L9nhat/Captone-Project/ban_ve in 3d 2.pdf

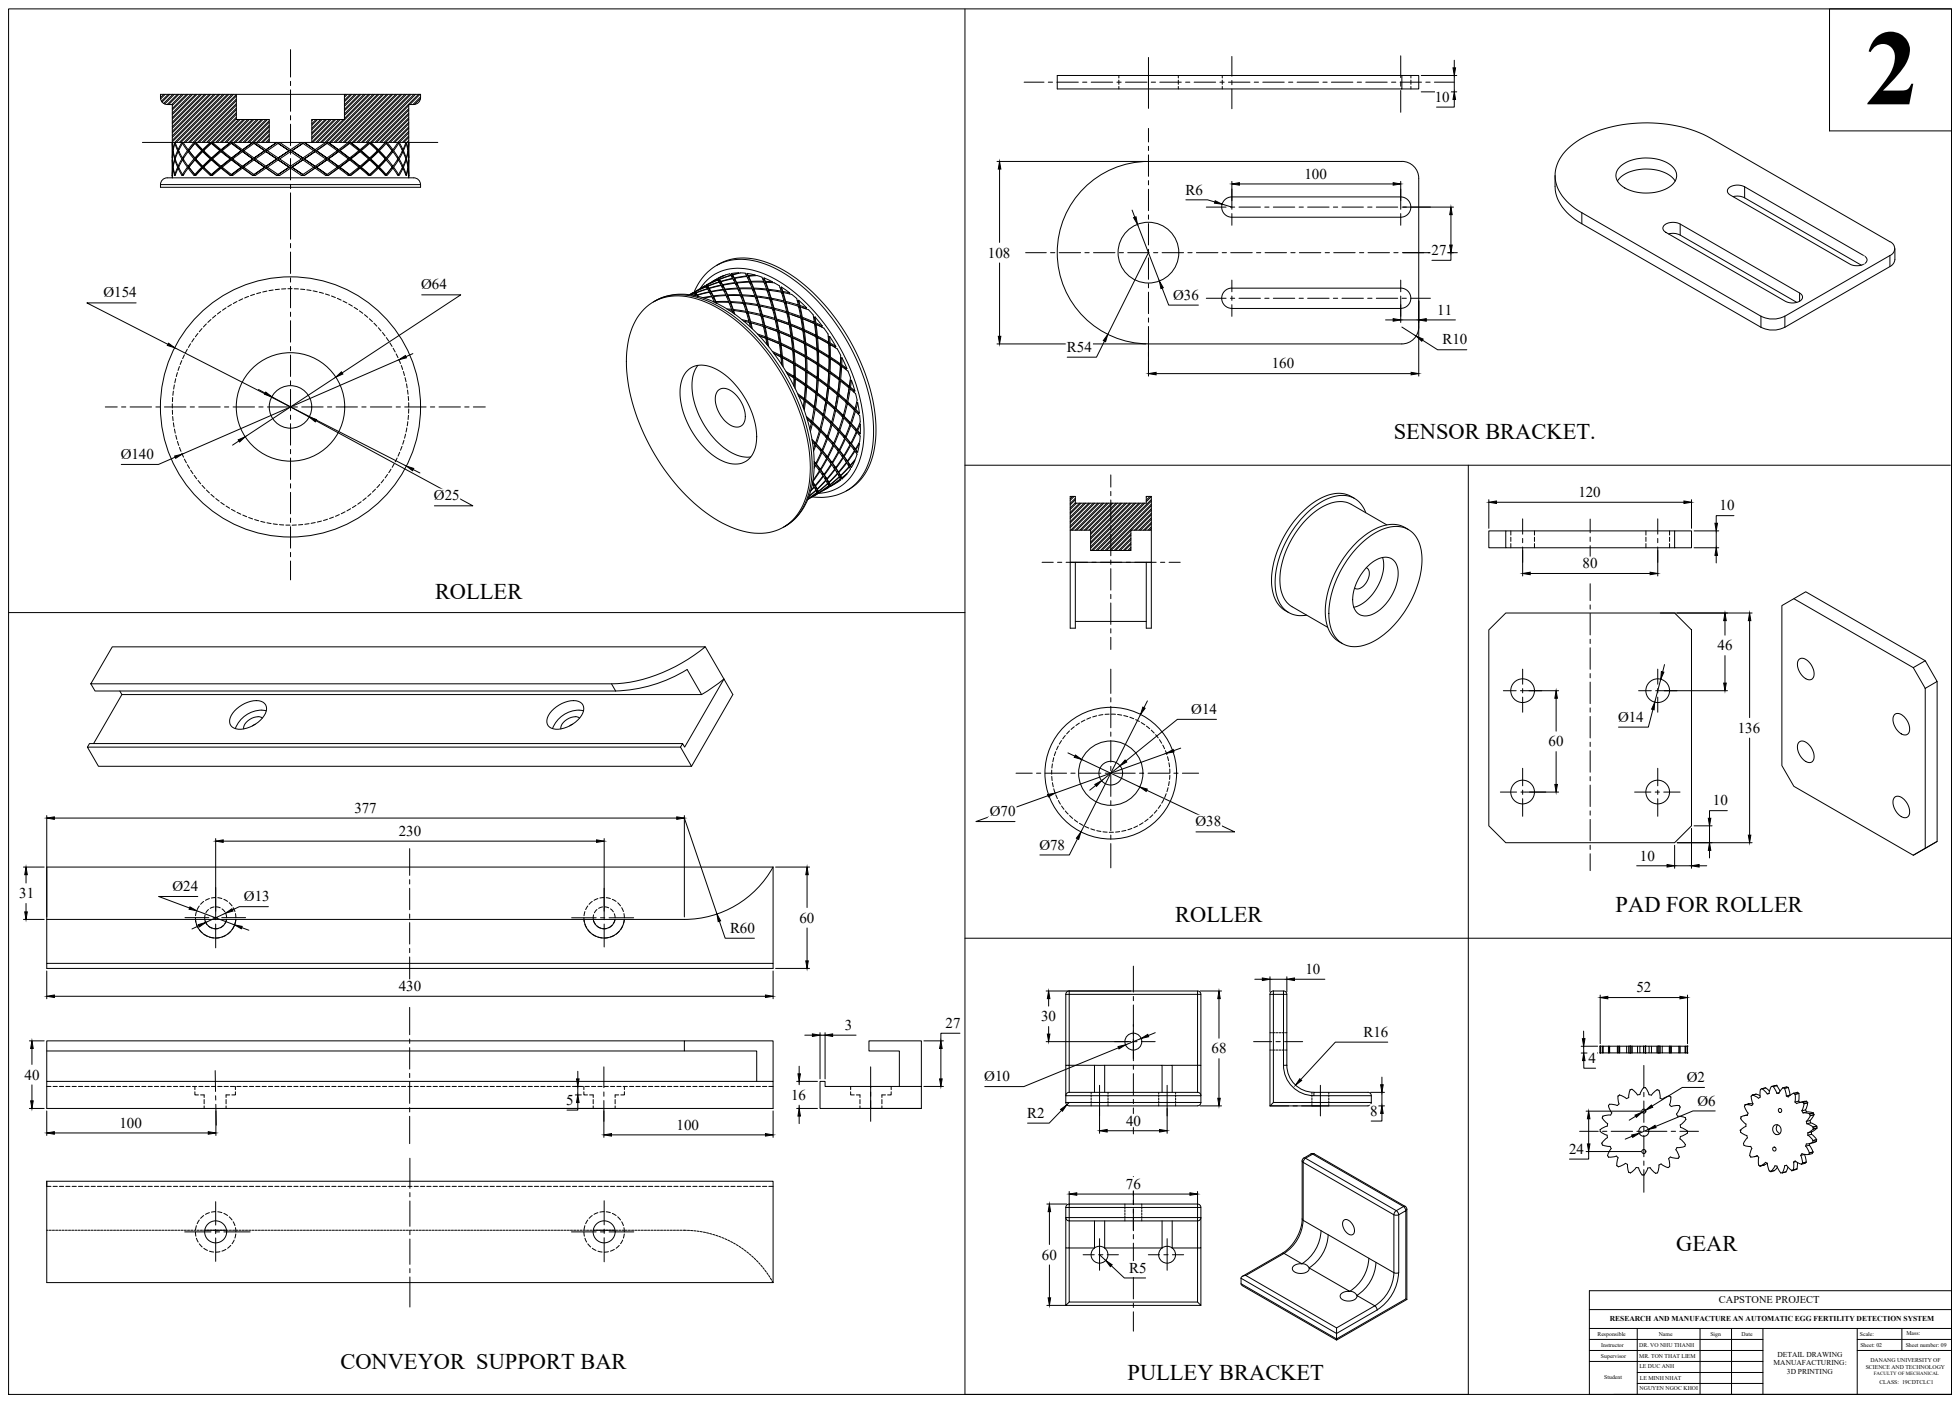
[picture p59: page 1]
ROLLER; SENSOR BRACKET. PAD FOR ROLLER CONVEYOR SUPPORT BAR; PULLEY BRACKET Ø14 Ø38 Ø78 Ø70 Ø64Ø25 Ø154Ø140; GEAR; 2 DETAIL DRAWING MANUAFACTURING: 3D PRINTING RESEARCH AND MANUFACTURE AN AUTOMATIC EGG FERTILITY DETECTION SYSTEM CAPSTONE PROJECT; Scale:; Sheet number: 09 Mass: Sheet: 02 DANANG UNIVERSITY OF SCIENCE AND TECHNOLOGY CLASS: 19CDTCLC1 Responsible Instructor Supervisor Student; Name; Sign; Date DR. VO NHU THANH LE MINH NHAT MR. TON THAT LIEM NGUYEN NGOC KHOI LE DUC ANH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
