L9nhat/Captone-Project/ban_ve in 3d.pdf

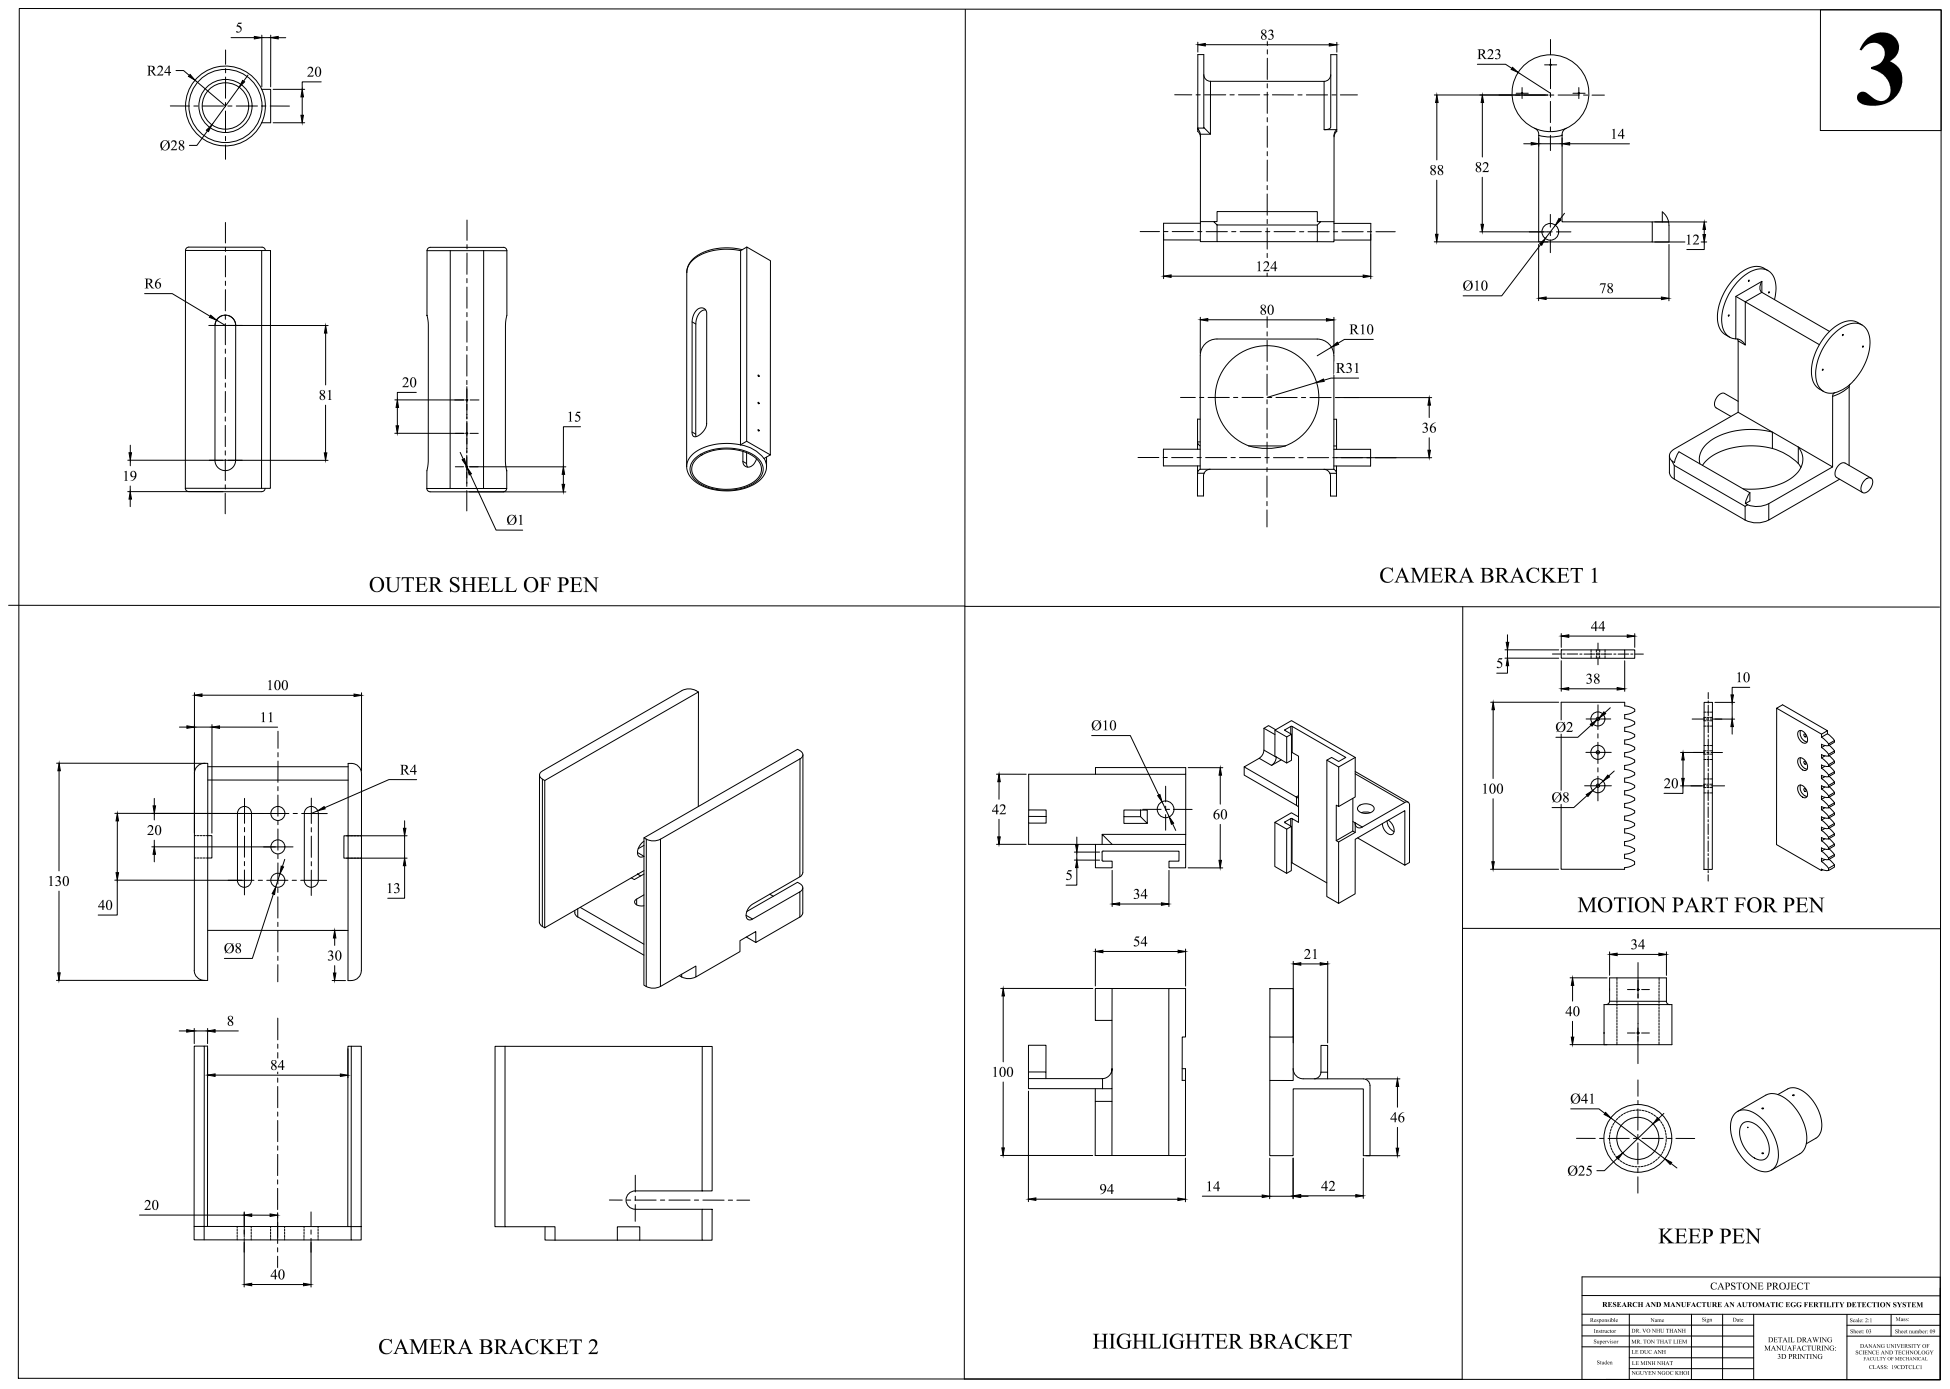
[picture p60: page 1]
OUTER SHELL OF PEN; CAMERA BRACKET 1 MOTION PART FOR PEN CAMERA BRACKET 2; HIGHLIGHTER BRACKET; KEEP PEN 130; 3 DETAIL DRAWING MANUAFACTURING: 3D PRINTING RESEARCH AND MANUFACTURE AN AUTOMATIC EGG FERTILITY DETECTION SYSTEM CAPSTONE PROJECT; Scale: 2:1; Sheet number: 09 Mass: Sheet: 03 DANANG UNIVERSITY OF SCIENCE AND TECHNOLOGY CLASS: 19CDTCLC1 Responsible Instructor Supervisor Studen; Name; Sign; Date DR. VO NHU THANH LE MINH NHAT MR. TON THAT LIEM NGUYEN NGOC KHOI LE DUC ANH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
