L9nhat/Captone-Project/ban_ve_cnc.pdf

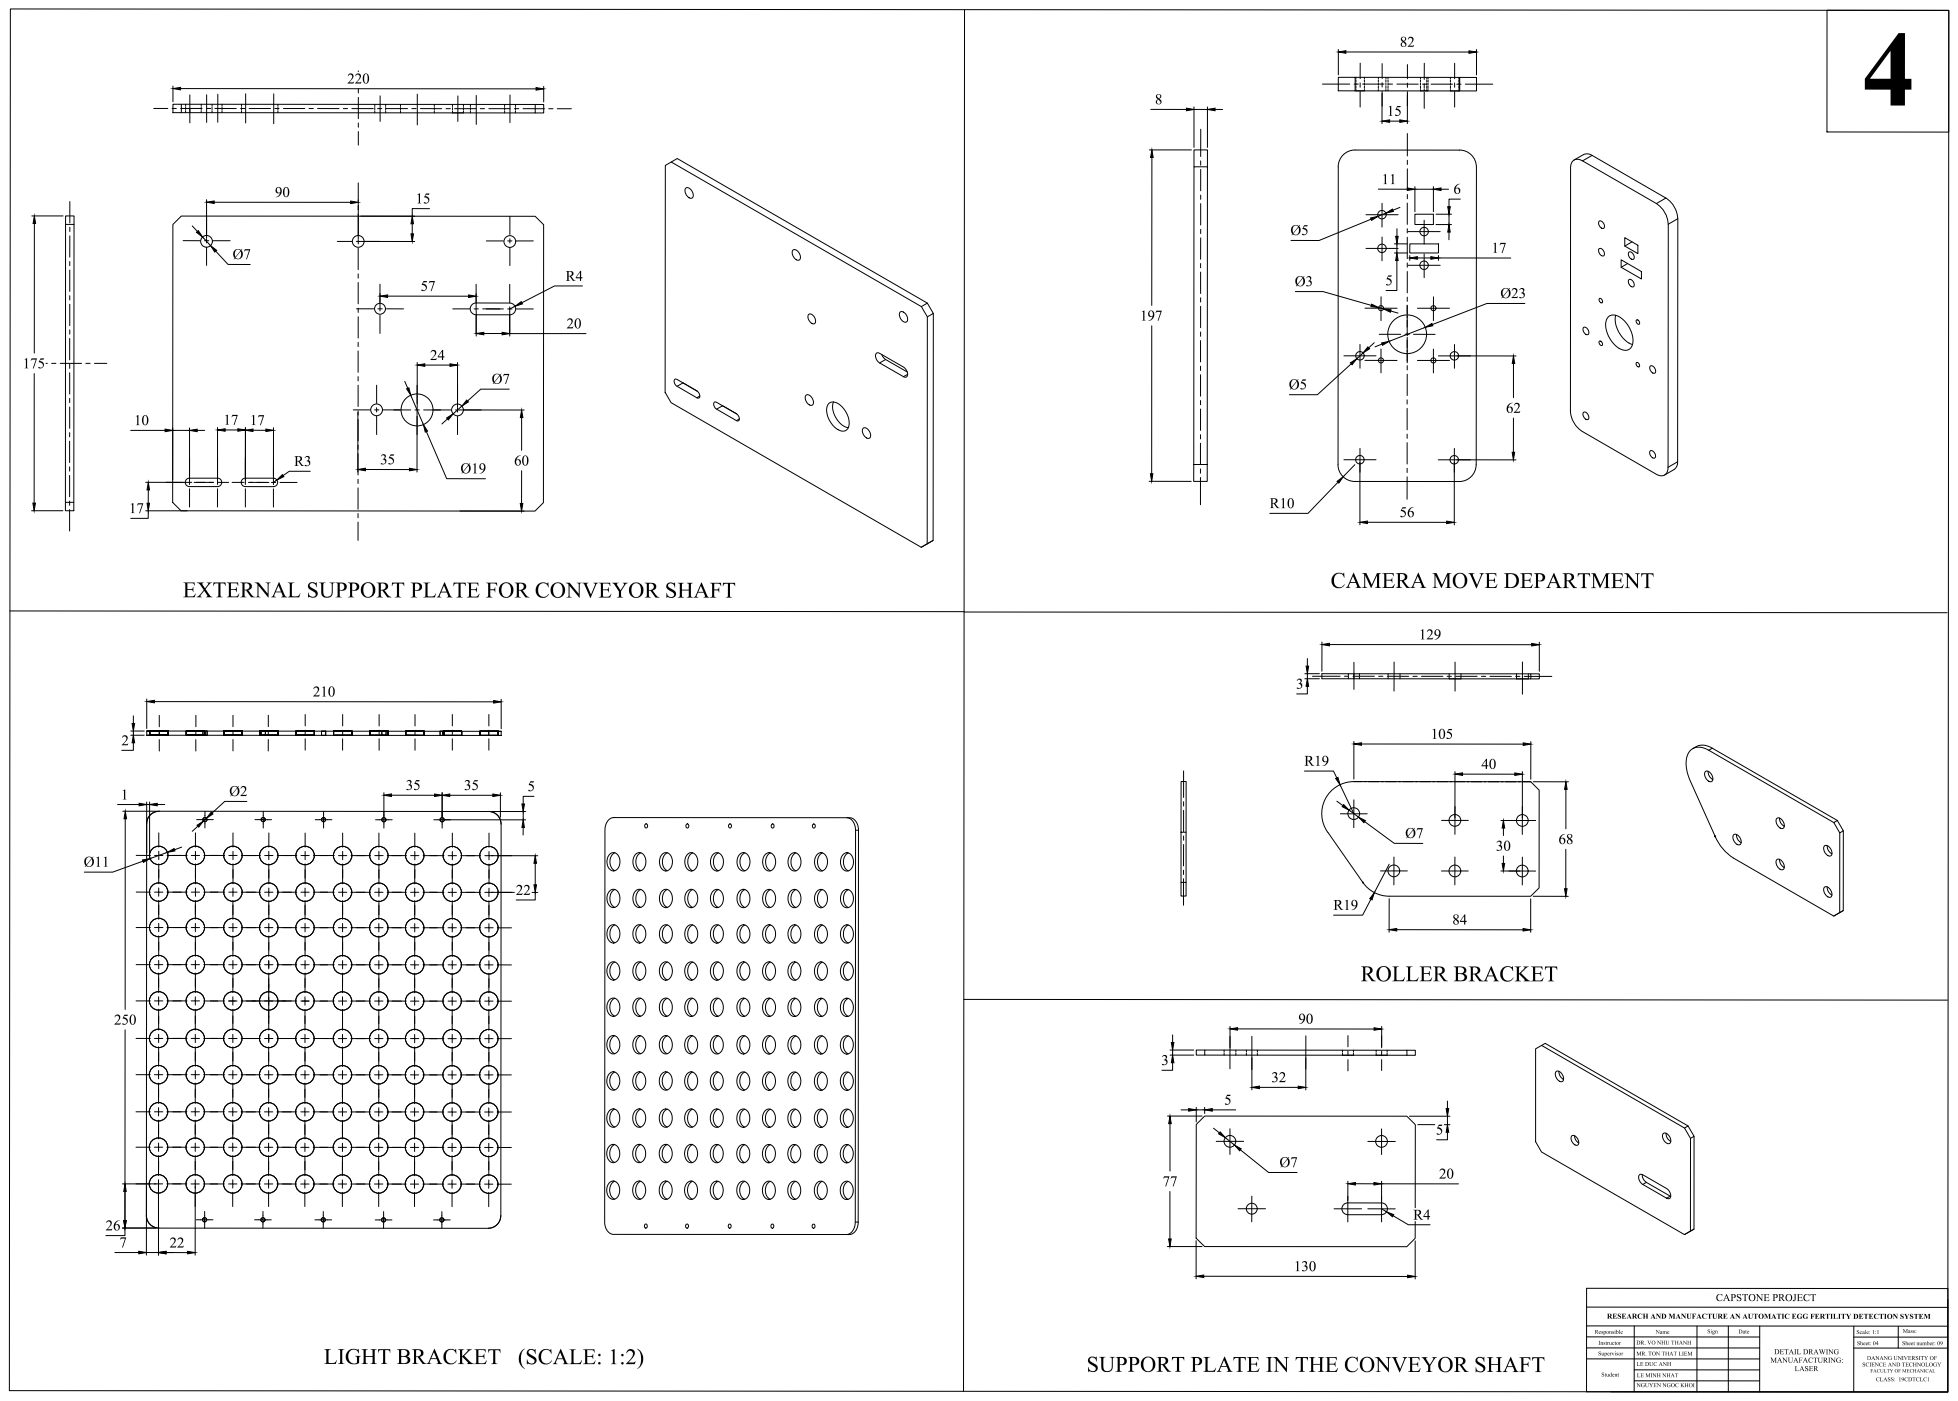
[picture p61: page 1]
EXTERNAL SUPPORT PLATE FOR CONVEYOR SHAFT; CAMERA MOVE DEPARTMENT LIGHT BRACKET (SCALE: 1:2); SUPPORT PLATE IN THE CONVEYOR SHAFT Ø7; ROLLER BRACKET68 105 Ø7; 4 DETAIL DRAWING MANUAFACTURING: LASER RESEARCH AND MANUFACTURE AN AUTOMATIC EGG FERTILITY DETECTION SYSTEM CAPSTONE PROJECT; Scale: 1:1; Sheet number: 09 Mass: Sheet: 04 DANANG UNIVERSITY OF SCIENCE AND TECHNOLOGY CLASS: 19CDTCLC1 Responsible Instructor Supervisor Student; Name; Sign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
