L9nhat/Captone-Project/Ban_ve_lap.pdf

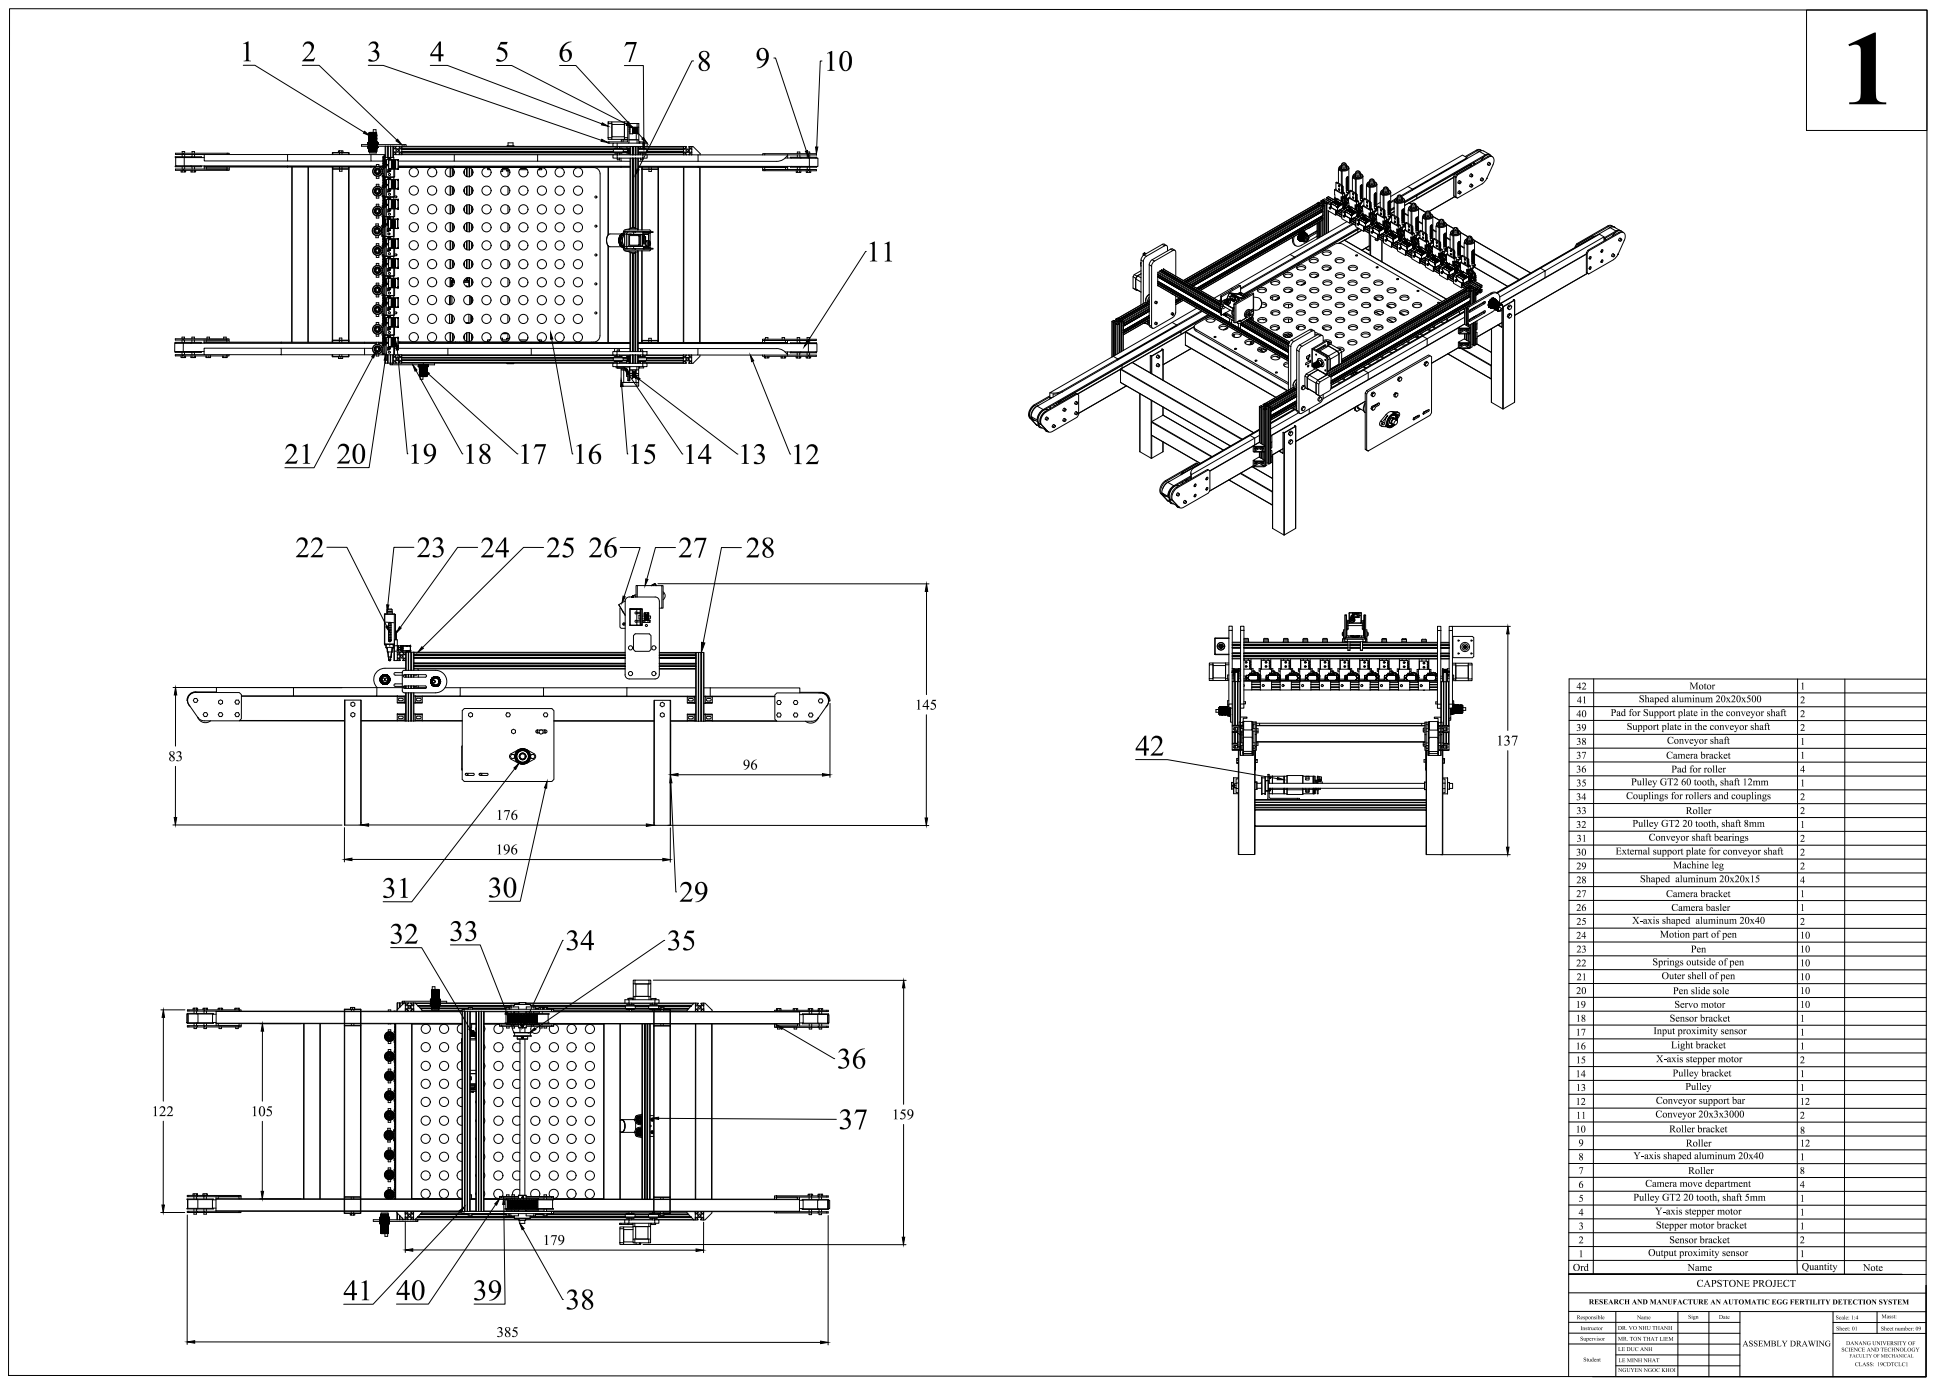
[picture p62: page 1]
Output proximity sensor Sensor bracket Stepper motor bracket Y-axis stepper motor Pulley GT2 20 tooth, shaft 5mm Camera move department Roller Y-axis shaped aluminum 20x40 Conveyor 20x3x3000 Conveyor support bar Pulley Pulley bracket X-axis stepper motor Light bracket Input proximity sensor Sensor bracket Servo motor Outer shell of pen Pen Motion part of pen X-axis shaped aluminum 20x40 Camera basler Camera bracket Shaped aluminum 20x20x15 Machine leg External support plate for conveyor shaft 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
