L9nhat/Captone-Project/Luu_do_thuat_toan.pdf

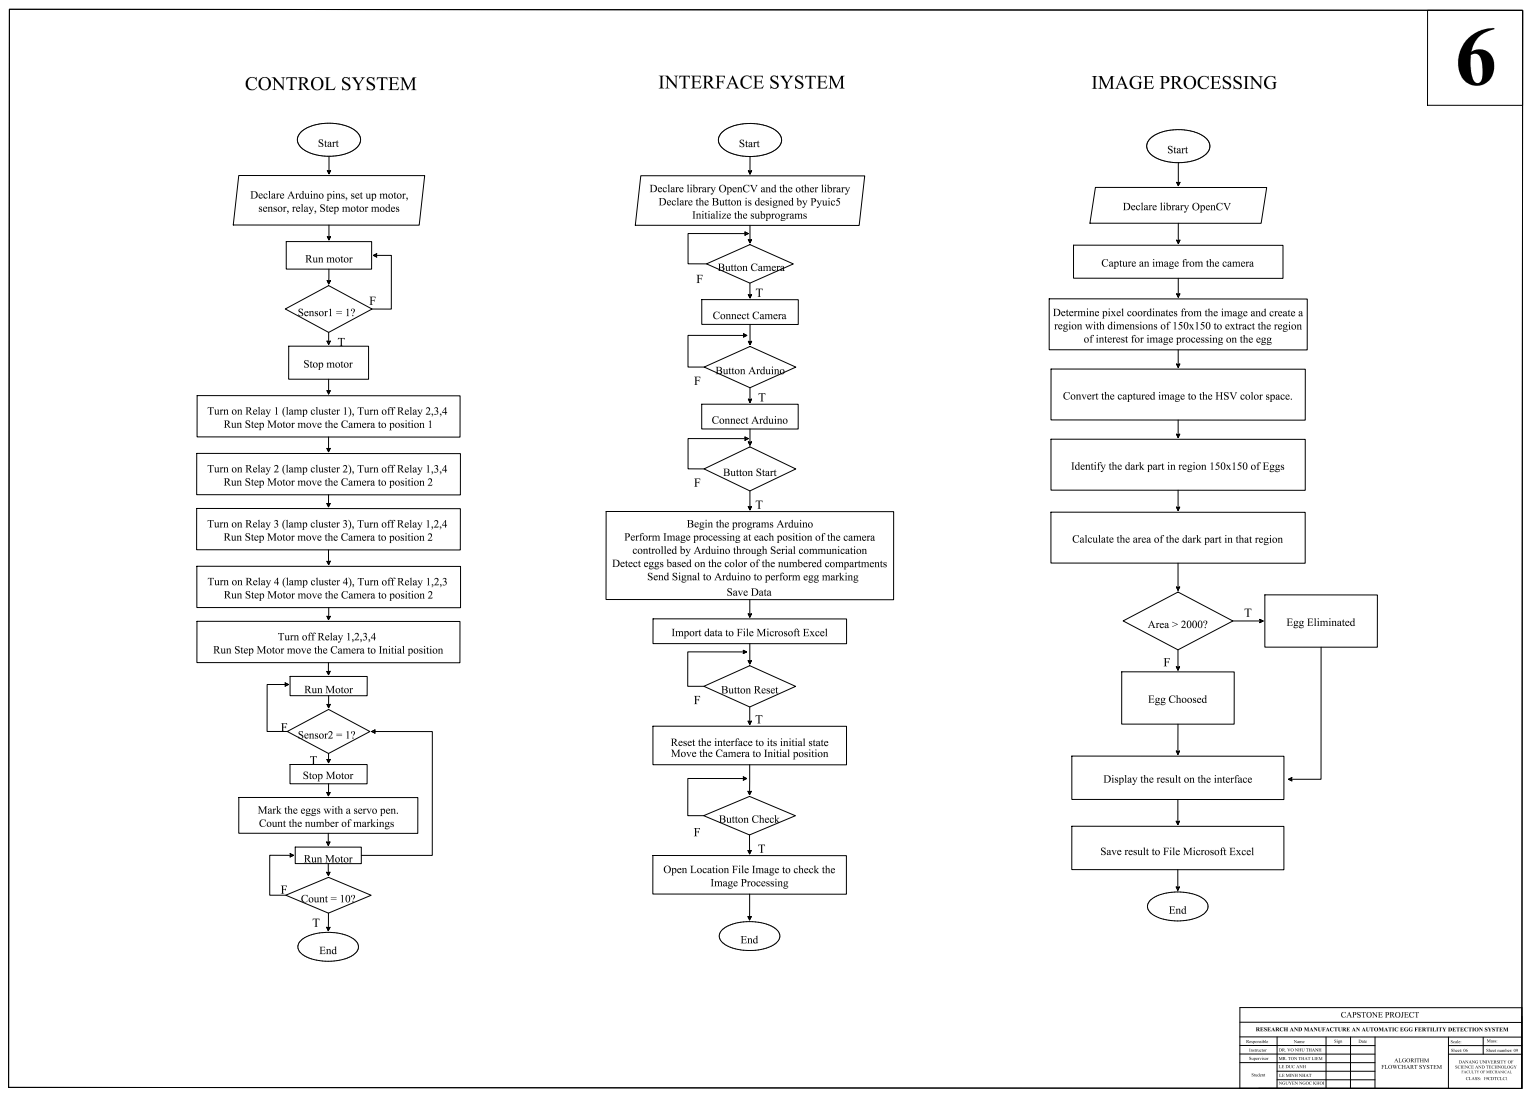
[picture p63: page 1]
6 ALGORITHM FLOWCHART SYSTEM RESEARCH AND MANUFACTURE AN AUTOMATIC EGG FERTILITY DETECTION SYSTEM CAPSTONE PROJECT; Scale:; Sheet number: 09 Mass: Sheet: 06 DANANG UNIVERSITY OF SCIENCE AND TECHNOLOGY CLASS: 19CDTCLC1 Responsible Instructor Supervisor Student; Name; Sign; Date DR. VO NHU THANH LE MINH NHAT MR. TON THAT LIEM NGUYEN NGOC KHOI LE DUC ANH; FACULTY OF MECHANICAL Start; Start Declare Arduino pins, set up motor, sensor, relay, Step motor modes Run motor Sensor1 = 1? T Stop motor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
