L9nhat/Captone-Project/So do dong hoc.pdf

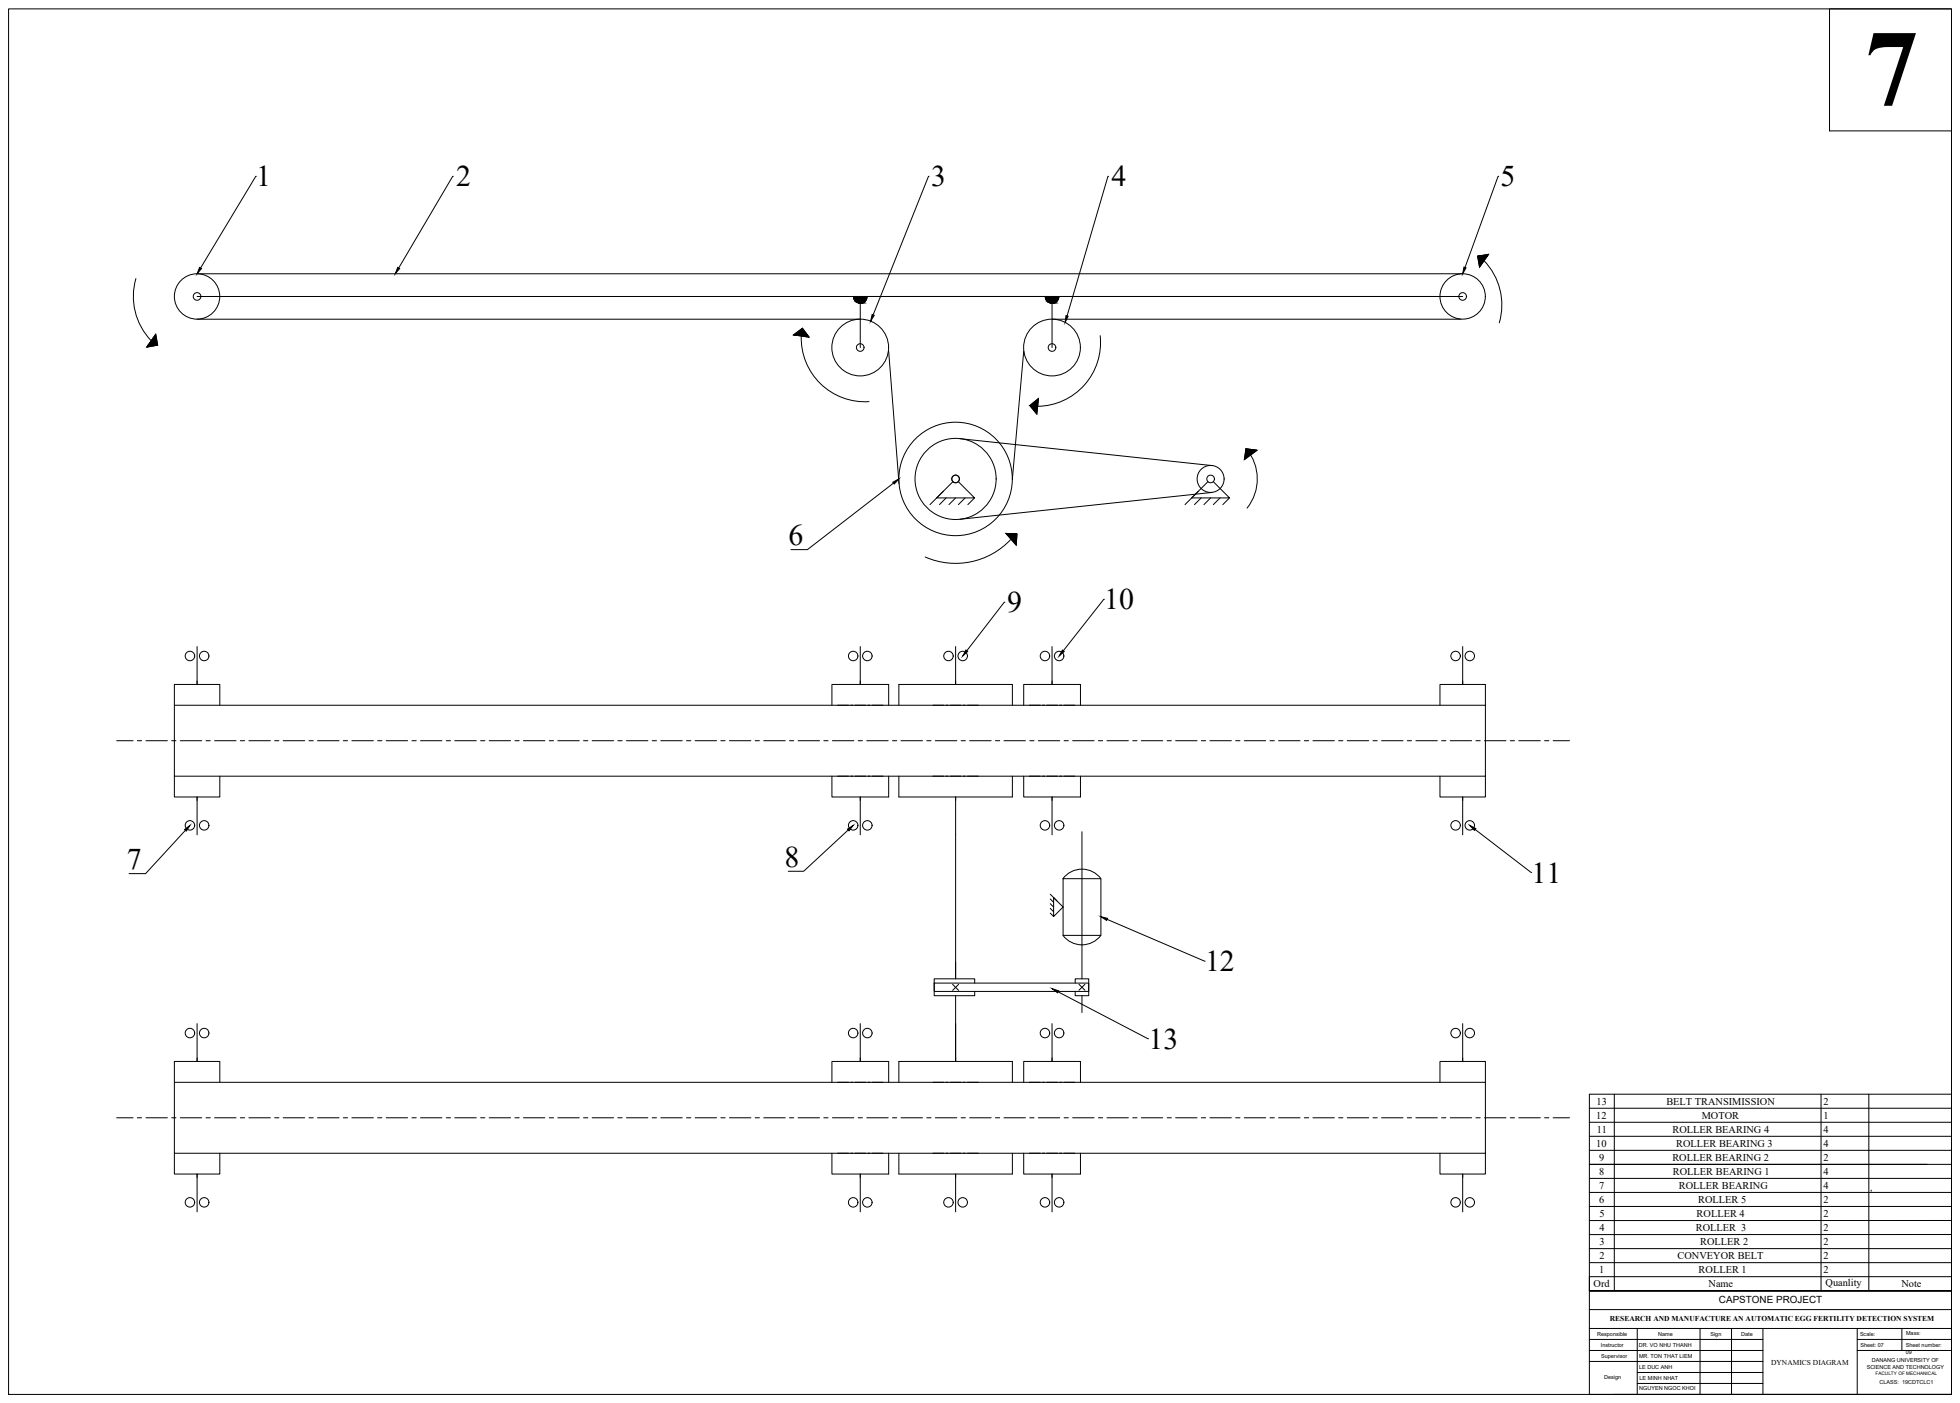
[picture p64: page 1]
ROLLER 1 CONVEYOR BELT ROLLER 2 ROLLER 3 ROLLER 4 ROLLER 5 ROLLER BEARING ROLLER BEARING 1; 4 7654321Ord; Name; Quanlity; Note 1; ROLLER BEARING 2 ROLLER BEARING 3 ROLLER BEARING 4 MOTOR BELT TRANSIMISSION; 7 DYNAMICS DIAGRAM RESEARCH AND MANUFACTURE AN AUTOMATIC EGG FERTILITY DETECTION SYSTEM CAPSTONE PROJECT; Scale:; Sheet number: 09Mass: Sheet: 07 DANANG UNIVERSITY OF SCIENCE AND TECHNOLOGY CLASS: 19CDTCLC1 Responsible Instructor Supervisor Design; Sign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
