L9nhat/Captone-Project/So do mach dieu khien.pdf

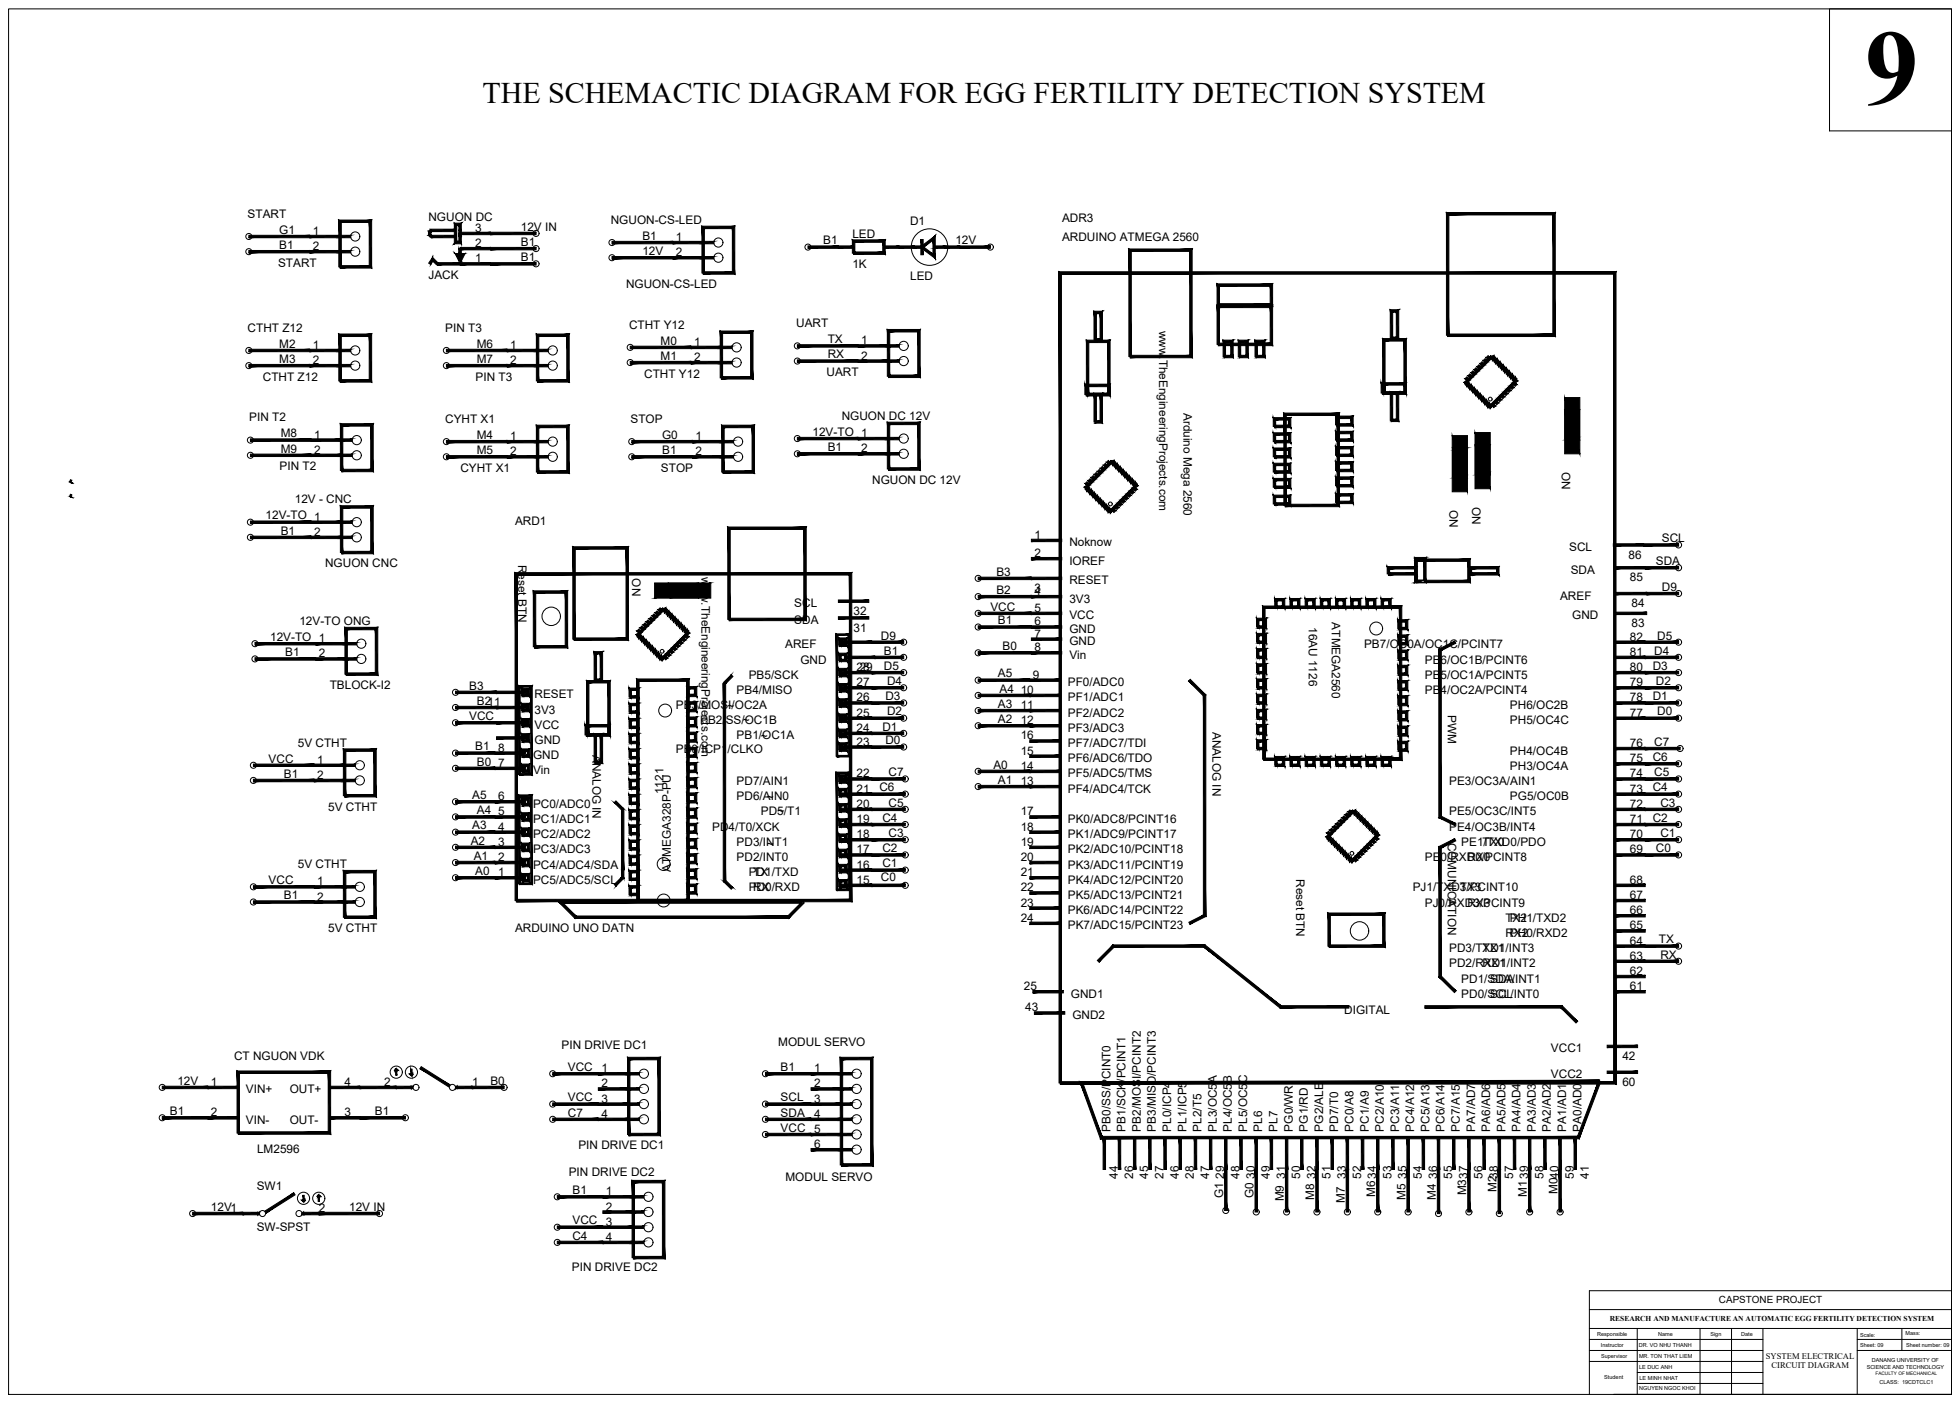
[picture p65: page 1]
D9B1D5D4 D3D2 D1D0C7 C6C5 C4C3 C2 C1 C0 12V-TO B1 VCCB1 VCCB1 12V-TO B1; TXRX 12V-TO B1 B1SCL SDA VCC VCC VCC C7B1VCC C4 12V IN B1; VCC 12V; B3B2 VCCB1B0 A5A4 A3A2 A0A1; ANALOG IN; 1121 ~ ~ ~~ ~ ~ TXRX; Reset BTN; 16AU 1126 TX0 TX3 TX2 TX1SDA SCL RX0 RX3 RX2 RX1

37 Noknow 1 IOREF 2 3V3 4 GND 7 Vin 8 GND1 25 GND2 43 SDA 85 SCL 86 VCC1 42 VCC2 60 GND 83 ADR3 ARDUINO ATMEGA 2560 THE SCHEMACTIC DIAGRAM FOR EGG FERTILITY DETECTION SYSTEM 9 SYSTEM ELECTRICAL CIRCUIT DIAGRAM RESEARCH AND MANUFACTURE AN AUTOMATIC EGG FERTILITY DETECTION SYSTEM CAPSTONE PROJECT Scale: Sheet number: 09 Mass: Sheet: 09 DANANG UNIVERSITY OF SCIENCE AND TECHNOLOGY CLASS: 19CDTCLC1 Responsible Instructor Supervisor Student Name Sign Date DR. VO NHU THANH LE MINH NHAT MR. TON THAT LIEM NGUYEN NGOC KHOI LE DUC ANH FACULTY OF MECHANICAL

www.TheEngineeringProjects.com PD0/RXD 15 PD1/TXD 16 PD2/INT0 17 PD3/INT1 18 PD4/T0/XCK 19 PD5/T1 20 PD6/AIN0 21 PD7/AIN1 22 PB0/ICP1/CLKO 23 PB1/OC1A 24 PB2/SS/OC1B 25 PB3/MOSI/OC2A 26 PB4/MISO 27 PB5/SCK 28 AREF PC5/ADC5/SCL 1 PC4/ADC4/SDA 2 PC3/ADC3 3 PC2/ADC2 4 PC1/ADC1 5 PC0/ADC0 6 RESET VCC GND GND 8 Vin 7 3V3 11 SCL 32 SDA 31 GND 29 ARD1 ARDUINO UNO DATN 12 12V-TO ONG TBLOCK-I2 12 5V CTHT 5V CTHT 12 5V CTHT 5V CTHT 12 12V - CNC NGUON CNC LED 1K D1 LED 321 NGUON DC JACK 12 NGUON-CS-LED NGUON-CS-LED 12 PIN T2PIN T2 12 PIN T3PIN T312 CYHT X1 CYHT X1 12 CTHT Z12 CTHT Z12 12 CTHT Y12 CTHT Y1212 STOPSTOP 12 STARTSTART 12 UARTUART 12 NGUON DC 12V NGUON DC 12V 123456 MODUL SERVO MODUL SERVO 1234 PIN DRIVE DC1 PIN DRIVE DC1 1234 PIN DRIVE DC2 PIN DRIVE DC2 1 2 SW1 SW-SPST VIN+ 1 VIN- 2 OUT+ 4 OUT- 3 LM2596 2 1 CT NGUON VDK

www.TheEngineeringProjects.com

Arduino Mega 2560 PD0/SCL/INT0 61 PD1/SDA/INT1 62 PD2/RXD1/INT2 63 PD3/TXD1/INT3 64 PH0/RXD2 65 PH1/TXD2 66 PJ0/RXD3/PCINT9 67 PJ1/TXD3/PCINT10 68 PE0/RXD0/PCINT8 69 PE1/TXD0/PDO 70 PE4/OC3B/INT4 71 PE5/OC3C/INT5 72 PG5/OC0B 73 PE3/OC3A/AIN1 74 PH3/OC4A 75 PH4/OC4B 76 PH5/OC4C 77 PH6/OC2B 78 PB4/OC2A/PCINT4 79 PB5/OC1A/PCINT5 80 PB6/OC1B/PCINT6 81 PB7/OC0A/OC1C/PCINT7 82 AREF 84 PK7/ADC15/PCINT23 24 PK6/ADC14/PCINT22 23 PK5/ADC13/PCINT21 22 PK4/ADC12/PCINT20 21 PK3/ADC11/PCINT19 20 PK2/ADC10/PCINT18 19 PK1/ADC9/PCINT17 18 PK0/ADC8/PCINT16 17 PF7/ADC7/TDI 16 PF6/ADC6/TDO 15 PF5/ADC5/TMS 14 PF4/ADC4/TCK 13 PF3/ADC3 12 PF2/ADC2 11 PF1/ADC1 10 PF0/ADC0 9 RESET 3 VCC 5 GND 6

M9 RX TX C0C1 C2C3 C4C5 C6C7D0 D1D2 D3D4D5D9 SDA SCL

PWM COMUNICATION DIGITAL
