L9nhat/Captone-Project/So_do_khoi.pdf

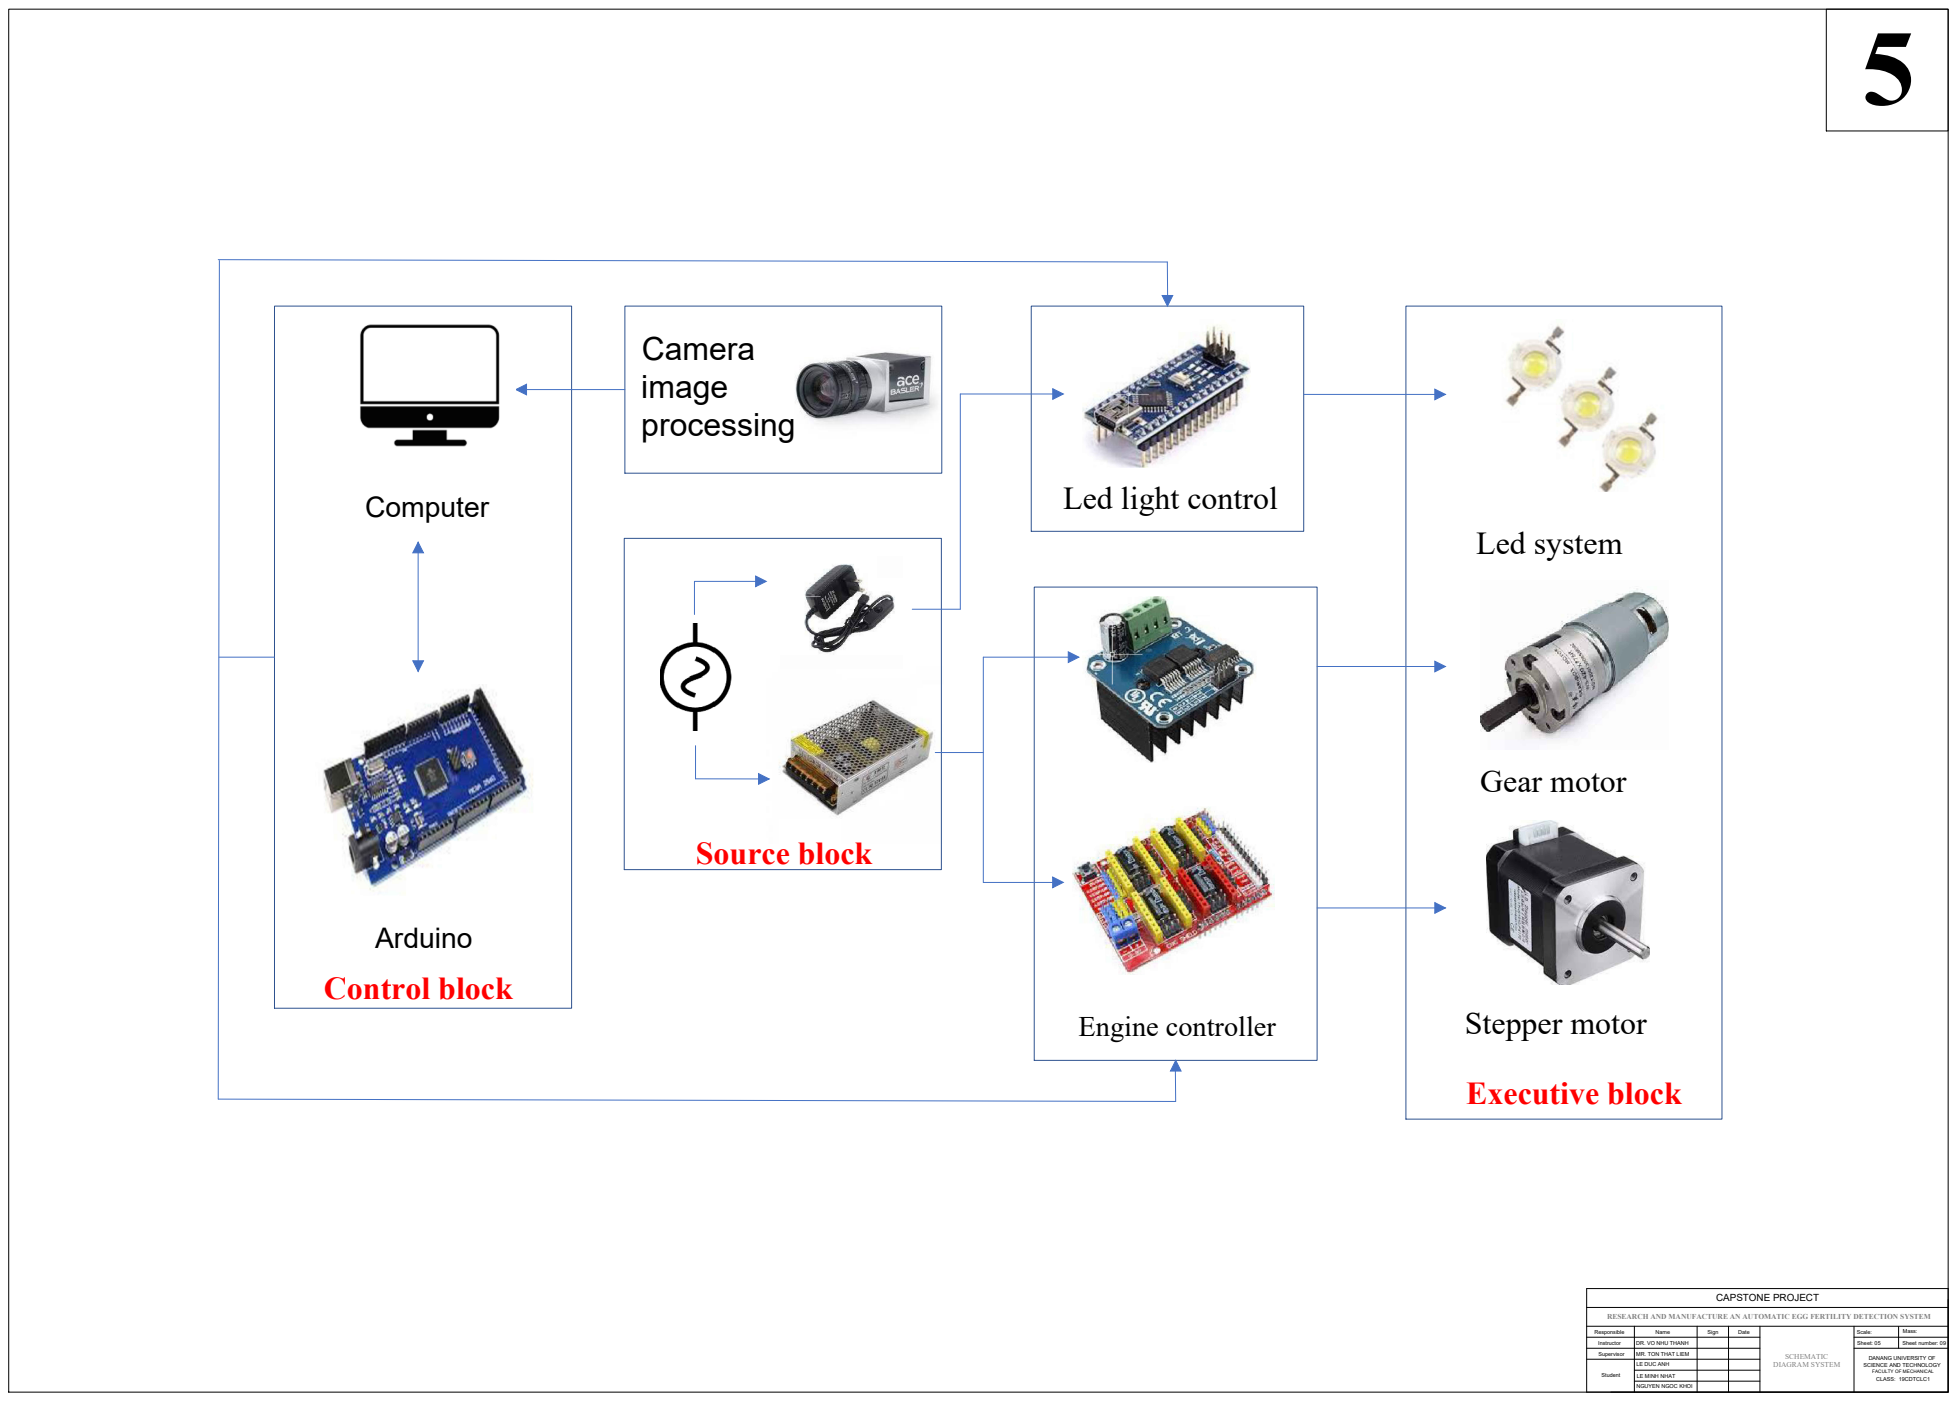
[picture p66: page 1]
5 SCHEMATIC DIAGRAM SYSTEM RESEARCH AND MANUFACTURE AN AUTOMATIC EGG FERTILITY DETECTION SYSTEM CAPSTONE PROJECT; Scale:; Sheet number: 09 Mass: Sheet: 05 DANANG UNIVERSITY OF SCIENCE AND TECHNOLOGY CLASS: 19CDTCLC1 Responsible Instructor Supervisor Student; Name; Sign; Date DR. VO NHU THANH LE MINH NHAT MR. TON THAT LIEM NGUYEN NGOC KHOI LE DUC ANH; FACULTY OF MECHANICAL Camera image processing Computer; Led light control; Led system Gear motor Source block Arduino Control block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
