L9nhat/Captone-Project/Sơ đồ mach dk led cs.pdf

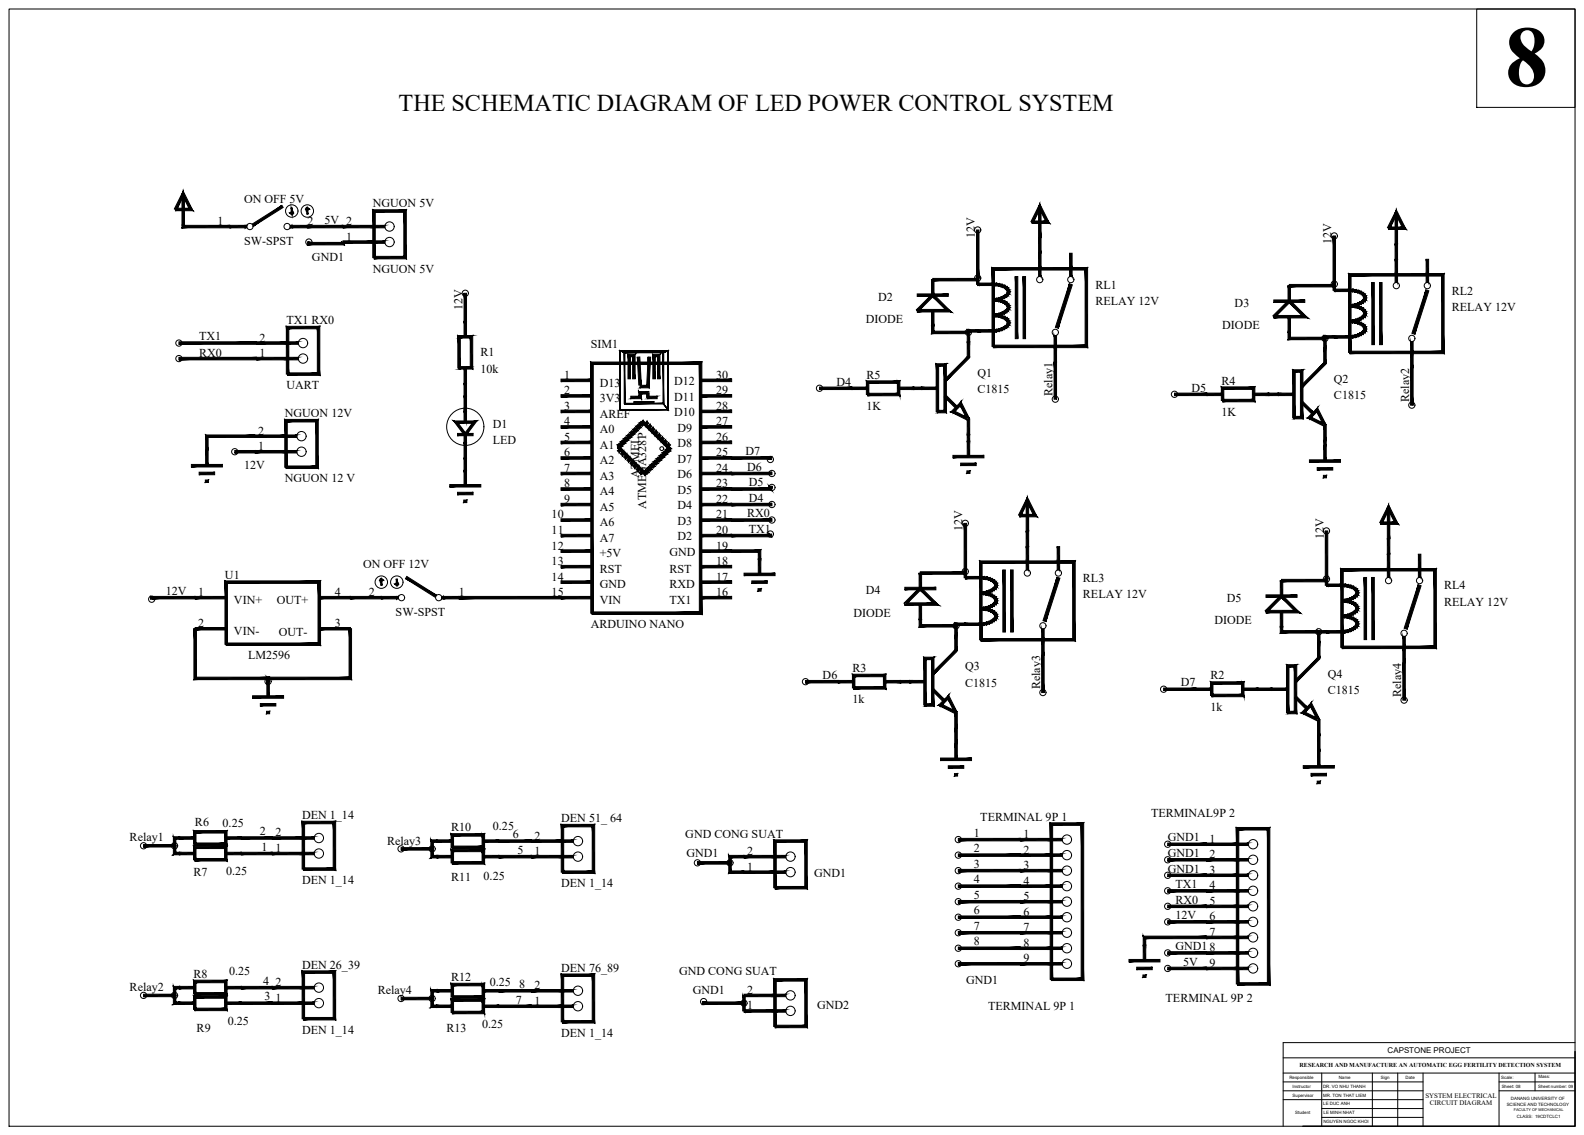
[picture p67: page 1]

THE SCHEMATIC DIAGRAM OF LED POWER CONTROL SYSTEM
